gromms/MiniSumo/README.md

# MiniSumo
Repository of mini sumo robot's electronics and programs of "Robotics Project" course.

# Team members
* Gromet Spaal
* Martin Maidla
* Simmo Saan
