gromms/MiniSumo/Sumo_main.step

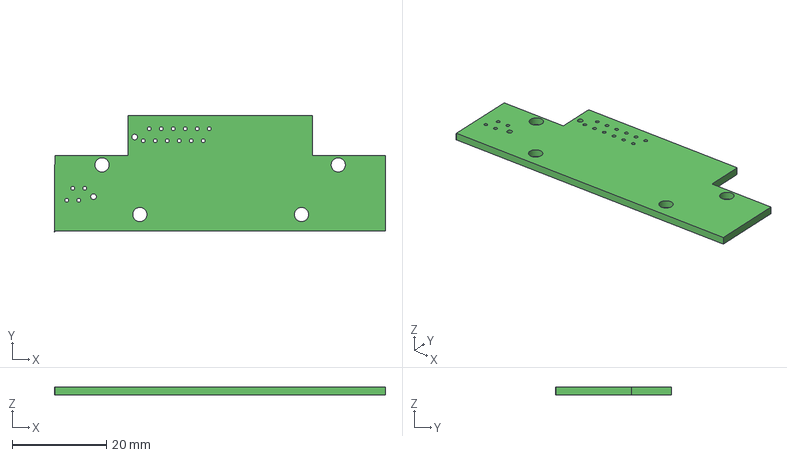
[picture p1: CAD file, 2016-04-14]
Sumo_main.step
70.1 x 24.6 x 1.59 mm
