gromms/MiniSumo/Sumo_control.step

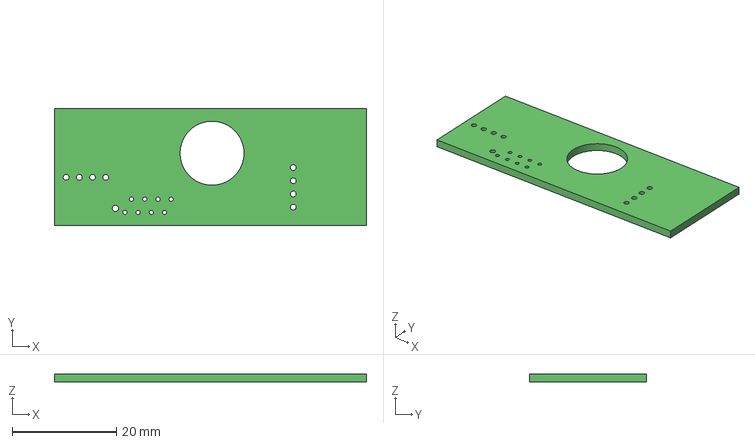
[picture p2: CAD file, 2016-04-14]
Sumo_control.step
60.0 x 22.5 x 1.59 mm
