gromms/MiniSumo/Sumo_sensors.brd

## EAGLE design Sumo_sensors.brd (2016-05-26)

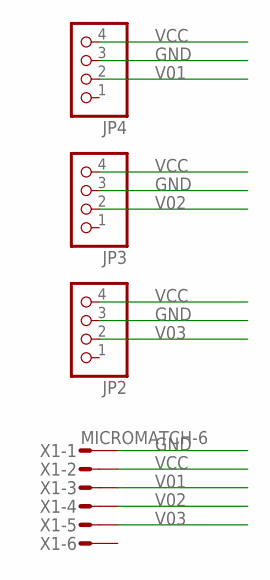
[picture p3: schematic Sumo_sensors.sch]

Parts:
JP2, JP3, JP4: PINHD-1X4; 1X04
X1: MICROMATCH-6

Connections:
GND: JP2.3, JP3.3, JP4.3, X1.1
V01: JP4.2, X1.3
V02: JP3.2, X1.4
V03: JP2.2, X1.5
VCC: JP2.4, JP3.4, JP4.4, X1.2

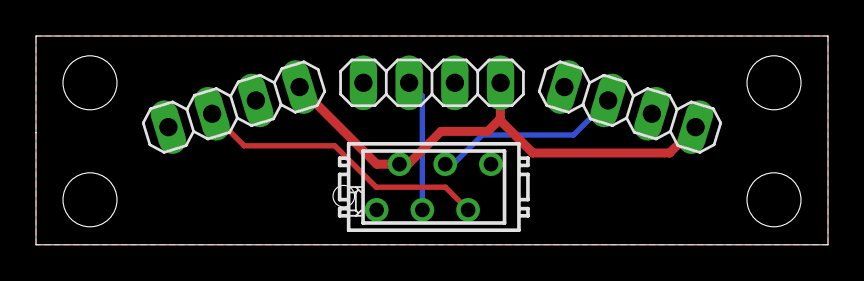
[picture p4: board Sumo_sensors.brd from above]

Board: 2 copper layers, 44.0 x 11.6 mm, 4 parts (0 on the bottom side), 5 nets.
