gromms/MiniSumo/Sumo_main.brd

## EAGLE design Sumo_main.brd (2016-05-26)

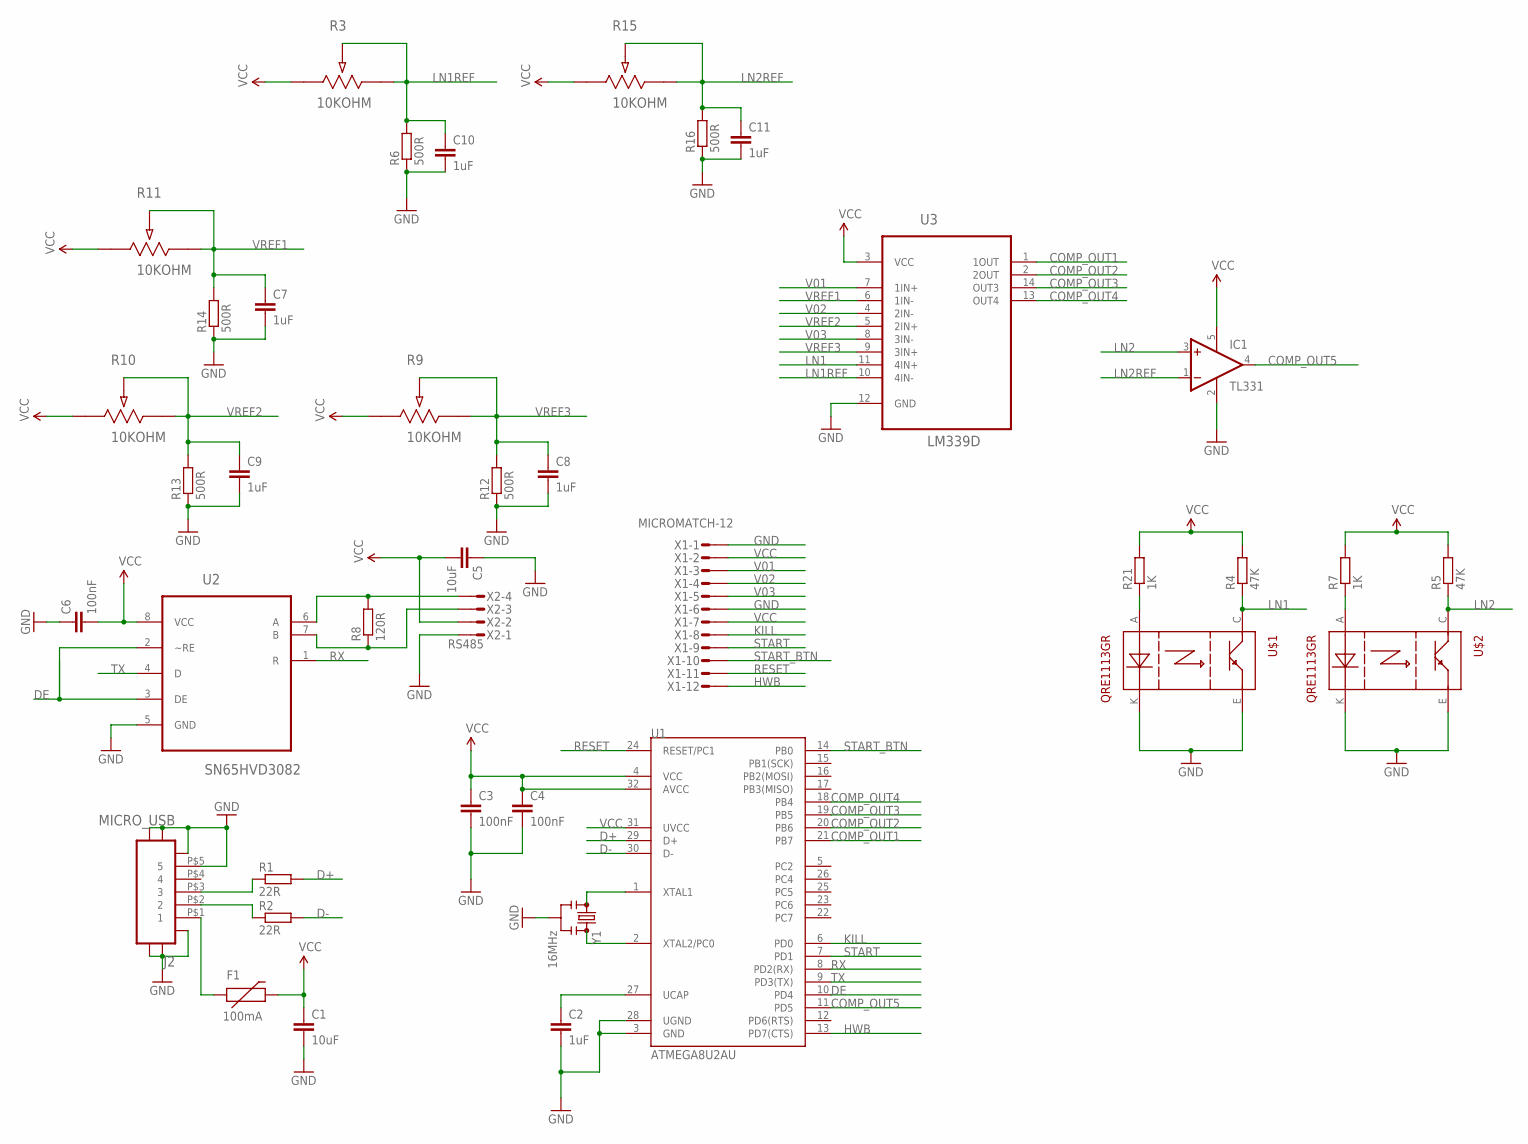
[picture p5: schematic Sumo_main.sch]

Parts:
C1, C5: 10uF; 0603-CAP
C2, C7, C8, C9, C10, C11: 1uF; 0603-CAP
C3, C4, C6: 100nF; 0603-CAP
F1: 100mA; PTC-1206
IC1: TL331; DBV-R-PDSO-G5
J2: MICRO_USB; MOLEX_47346-0001
R1, R2: 22R; R0603
R3, R9, R10, R11, R15: 10KOHM; POT_EVM3W
R4, R5: 47K; R0603
R6, R12, R13, R14, R16: 500R; R0603
R7, R21: 1K; R0603
R8: 120R; R0603
U1: ATMEGA8U2AU; TQFP32-08
U2: SN65HVD3082; SOIC127P600X175-8N
U3: LM339D; SOIC127P600X175-14N
U$1, U$2: QRE1113GR; 4LEADSMD
X1: MICROMATCH-12
X2: RS485; MICROMATCH-4
Y1: 16MHz; RESONATOR-SMD_MED

Connections:
COMP_OUT1: U1.21 (PB7), U3.1 (1OUT)
COMP_OUT2: U1.20 (PB6), U3.2 (2OUT)
COMP_OUT3: U1.19 (PB5), U3.14 (OUT3)
COMP_OUT4: U1.18 (PB4), U3.13 (OUT4)
COMP_OUT5: IC1.4 (OUT), U1.11 (PD5)
D+: R1.2, U1.29 (D+)
D-: R2.2, U1.30 (D-)
DE: U1.10 (PD4), U2.2 (~RE), U2.3 (DE)
GND: C1.2, C2.2, C3.2, C4.2, C5.1, C6.1, C7.2, C8.2, C9.2, C10.2, C11.2, IC1.2 (GND), J2.M1, J2.M2, J2.M3, J2.M4, J2.M5, J2.M6, J2.P$5 (5), R6.1, R12.1, R13.1, R14.1, R16.1, U1.3 (GND), U1.28 (UGND), U2.5 (GND), U3.12 (GND), U$1.E, U$1.K, U$2.E, U$2.K, X1.1, X1.6, X2.1, Y1.2
HWB: U1.13 (PD7(CTS)), X1.12
KILL: U1.6 (PD0), X1.8
LN1: R4.1, U3.11 (4IN+), U$1.C
LN1REF: C10.1, R3.2, R3.3, R6.2, U3.10 (4IN-)
LN2: IC1.3 (+IN), R5.1, U$2.C
LN2REF: C11.1, IC1.1 (-IN), R15.2, R15.3, R16.2
unnamed: J2.P$3 (3), R1.1
unnamed: J2.P$2 (2), R2.1
unnamed: F1.1, J2.P$1 (1)
unnamed: R21.1, U$1.A
unnamed: U1.1 (XTAL1), Y1.1
unnamed: U1.2 (XTAL2/PC0), Y1.3
unnamed: C2.1, U1.27 (UCAP)
unnamed: R7.1, U$2.A
unnamed: R8.2, U2.6 (A), X2.4
unnamed: R8.1, U2.7 (B), X2.3
RESET: U1.24 (RESET/PC1), X1.11
RX: U1.8 (PD2(RX)), U2.1 (R)
START: U1.7 (PD1), X1.9
START_BTN: U1.14 (PB0), X1.10
TX: U1.9 (PD3(TX)), U2.4 (D)
V01: U3.7 (1IN+), X1.3
V02: U3.4 (2IN-), X1.4
V03: U3.8 (3IN-), X1.5
VCC: C1.1, C3.1, C4.1, C5.2, C6.2, F1.2, IC1.5 (V+), R3.1, R4.2, R5.2, R7.2, R9.1, R10.1, R11.1, R15.1, R21.2, U1.4 (VCC), U1.31 (UVCC), U1.32 (AVCC), U2.8 (VCC), U3.3 (VCC), X1.2, X1.7, X2.2
VREF1: C7.1, R11.2, R11.3, R14.2, U3.6 (1IN-)
VREF2: C9.1, R10.2, R10.3, R13.2, U3.5 (2IN+)
VREF3: C8.1, R9.2, R9.3, R12.2, U3.9 (3IN+)

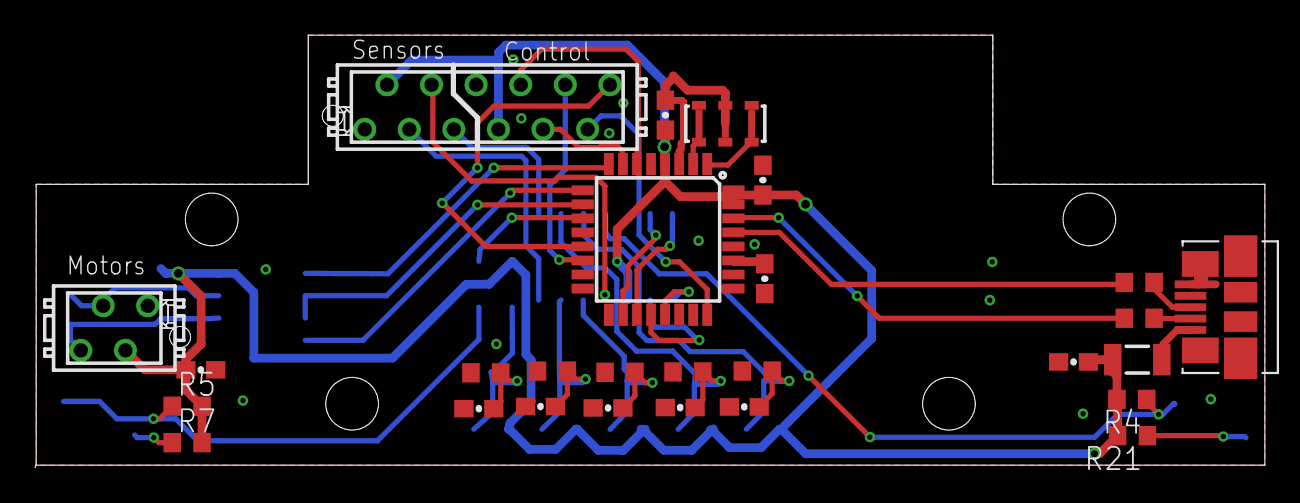
[picture p6: board Sumo_main.brd from above]

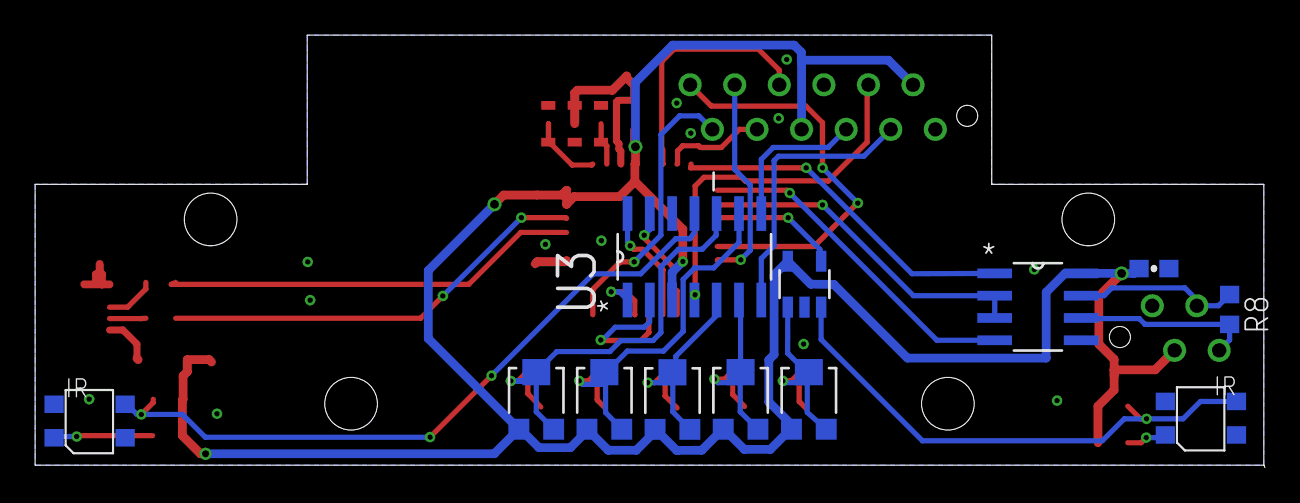
[picture p7: board Sumo_main.brd from below]

Board: 2 copper layers, 70.0 x 24.5 mm, 39 parts (12 on the bottom side), 37 nets.
