gromms/MiniSumo/Sumo_control.brd

## EAGLE design Sumo_control.brd (2016-04-14)

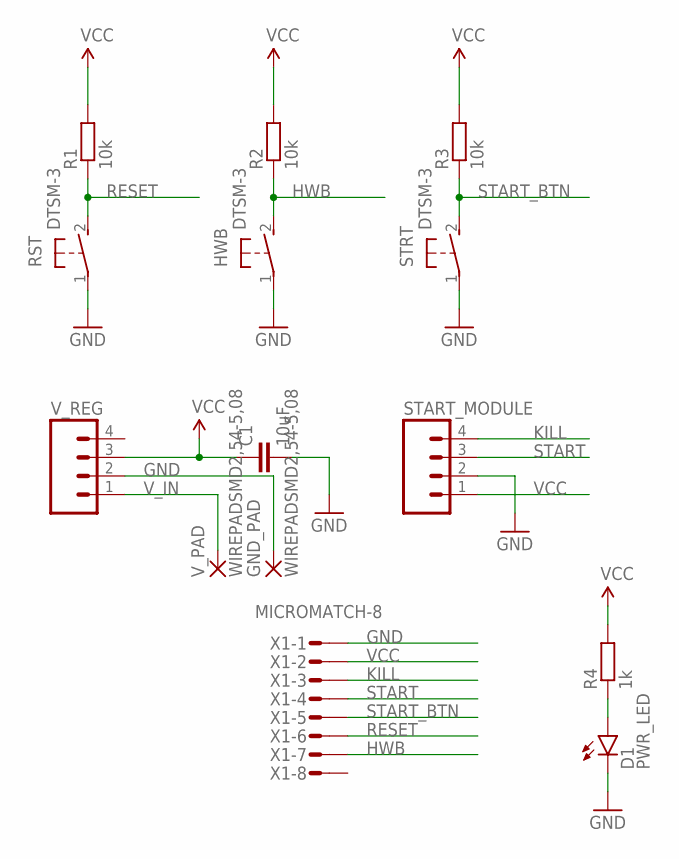
[picture p8: schematic Sumo_control.sch]

Parts:
C1: 10uF; 0603-CAP
D1: PWR_LED; LED-0603
GND_PAD: WIREPADSMD2,54-5,08; SMD2,54-5,08
HWB: DTSM-3
R1, R2, R3: 10k; R0603
R4: 1k; R0603
RST: DTSM-3
START_MODULE: M04LONGPADS; 1X04_LONGPADS
STRT: DTSM-3
V_PAD: WIREPADSMD2,54-5,08; SMD2,54-5,08
V_REG: M04LONGPADS; 1X04_LONGPADS
X1: MICROMATCH-8

Connections:
GND: C1.2, D1.C, GND_PAD.1, HWB.1, RST.1, START_MODULE.2, STRT.1, V_REG.2, X1.1
HWB: HWB.2, R2.1, X1.7
KILL: START_MODULE.4, X1.3
unnamed: D1.A, R4.1
RESET: R1.1, RST.2, X1.6
START: START_MODULE.3, X1.4
START_BTN: R3.1, STRT.2, X1.5
VCC: C1.1, R1.2, R2.2, R3.2, R4.2, START_MODULE.1, V_REG.3, X1.2
V_IN: V_PAD.1, V_REG.1

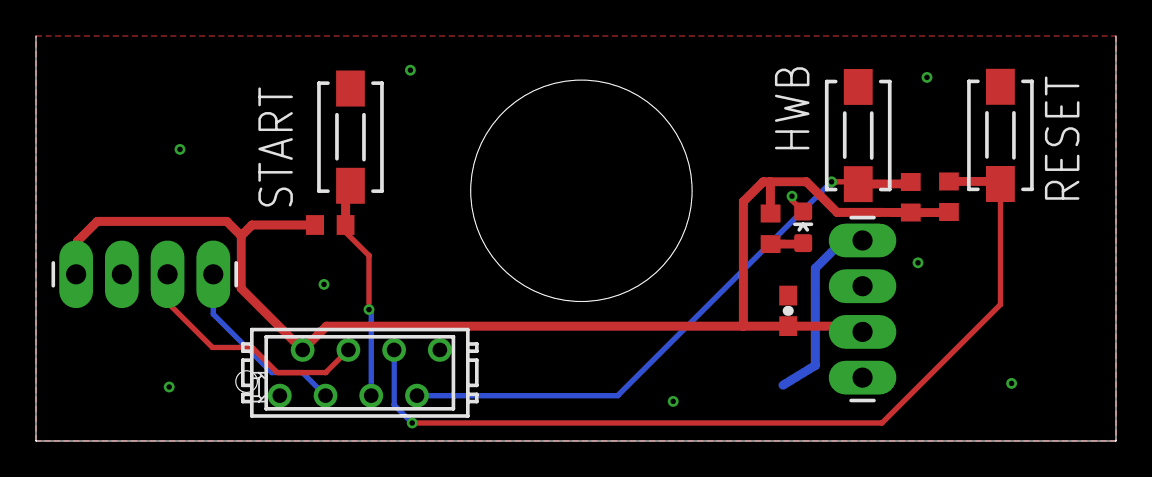
[picture p9: board Sumo_control.brd from above]

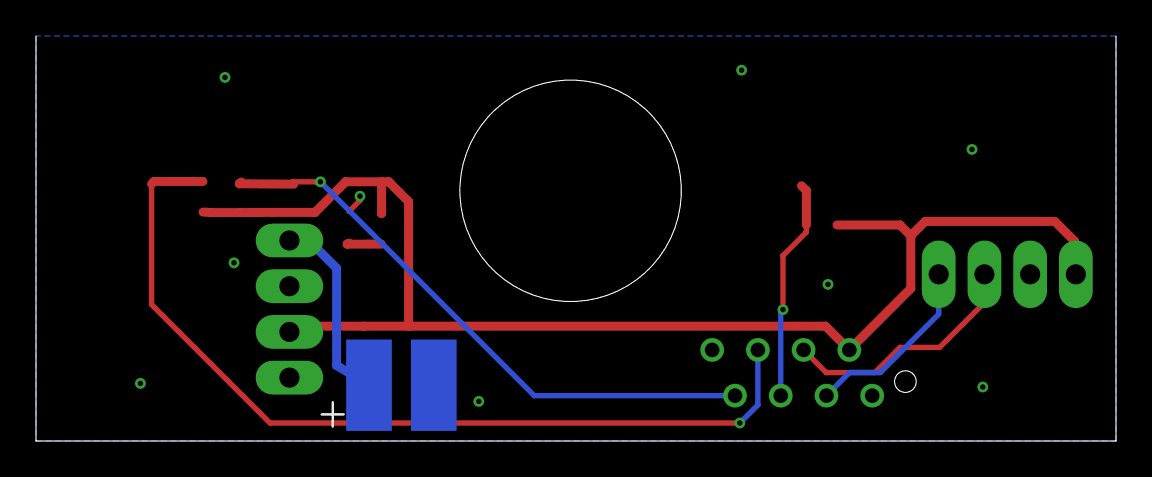
[picture p10: board Sumo_control.brd from below]

Board: 2 copper layers, 60.0 x 22.5 mm, 14 parts (2 on the bottom side), 9 nets.
