gromms/MiniSumo/(threads)

Thread 13 (2016-05-31):

Prevent LiPo draining

sim642, 2016-05-31:
Possible solutions:
- LiPo alarms (could maybe fit under top layer) - requires connector to split off
- Measurement and shutdown by external chip
- Measurement and shutdown by atmega

gromms, 2016-06-01:
Motors' power could be switched by a relay. In that case we could use a LiPo alarm that would send a signal to cut off the power to motors. (Con: size of relays)
