gromms/MiniSumo/(commit log)

2016-02-04 Added schematic file
    [Sumo_main.sch]
2016-02-04 Added RS-485
    [Sumo_main.sch]
2016-02-09 Added Non-USB voltage supply.
    [Sumo_main.sch]
2016-02-10 Changed RS485 module, added start module and power voltage regulator.
    [Sumo_main.sch]
2016-02-10 Changed power switch in schematic for pin headers to connect it with wires later.
    [Sumo_main.sch]
2016-02-10 Bug fixes.
    [Sumo_main.sch]
2016-02-10 Signal bug fixes.
    [Sumo_main.sch]
2016-02-10 Added capacitor to RS-485 chip's VCC and connected RS-485 micromatch VCC capacitor to ground.
    [Sumo_main.sch]
2016-02-10 Added ready board and Gerber files.
    [Sumo_main.GBL, Sumo_main.GBO, Sumo_main.GBP, Sumo_main.GBS, Sumo_main.GTL, Sumo_main.GTO, Sumo_main.GTP, Sumo_main.GTS]
2016-02-10 Added PNGs of schematic and board, added text to schematic and board and shortened some components' names.
    [Sumo_main.GBL, Sumo_main.GBO, Sumo_main.GBP, Sumo_main.GBS, Sumo_main.GTL, Sumo_main.GTO, Sumo_main.GTP, Sumo_main.GTS]
2016-02-16 Version 2 - added comparator for sensor signals, redesigned board to be more compact.
    [Sumo_main.brd, Sumo_main.sch]
2016-02-16 Re-routed X6 signal and VCC.
    [Sumo_main.brd]
2016-02-16 Moved ATMEGA more to center of the board.
    [Sumo_main.brd]
2016-02-18 Made the board more compact.
    [Sumo_main.brd]
2016-03-03 Added additional button for starting. Changed IR sensors' micromatches to pinheaders.
    [Sumo_main.brd, Sumo_main.sch]
2016-03-09 Add two IR reflection sensors to detect lines.
    [Sumo_main.brd, Sumo_main.sch]
2016-03-09 Add PNG pictures of v04 Schematic and Board.
2016-04-04 Add line sensor to schematic.
    [Sumo_main.sch]
2016-04-04 Start arranging new board.
    [Sumo_main.brd]
2016-04-04 Remove unnecessary components that are moved to other board.
    [Sumo_main.sch]
2016-04-04 Board redesign. TODO: Connect HWB
    [Sumo_main.brd]
2016-04-04 Add control board schematic and board
    [Sumo_control.brd, Sumo_control.sch]
2016-04-05 Finish and fix errors of Main's schematic and board
    [Sumo_main.brd, Sumo_main.sch]
2016-04-05 Wire one unwired signal
    [Sumo_main.brd]
2016-04-05 Remove old Gerber folder and files
    [Sumo_main.GBL, Sumo_main.GBO, Sumo_main.GBP, Sumo_main.GBS, Sumo_main.GTL, Sumo_main.GTO, Sumo_main.GTP, Sumo_main.GTS]
2016-04-05 Adjust control board to meet right EDC requirements
    [Sumo_control.brd]
2016-04-12 Add mounting holes to board and re-route some wires to get rid of some vias.
    [Sumo_main.brd]
2016-04-12 Adjust GND plate to actual board shape
    [Sumo_main.brd]
2016-04-12 Adjust blocks' placements
    [Sumo_main.sch]
2016-04-12 Add isolation to polygon
    [Sumo_control.brd]
2016-04-12 Mark correct PCB shape
    [Sumo_main.brd]
2016-04-12 Replace power pads with bigger ones
    [Sumo_control.brd, Sumo_control.sch]
2016-04-14 Add STEP files of component-less main board
    [Sumo_control.step, Sumo_main.step]
2016-04-14 Final modifications before test order
    [Sumo_control.brd, Sumo_control.sch, Sumo_main.brd]
2016-05-13 Tested dual motor communication and all distance sensors
2016-05-24 Swap light sensor left and right to match reality
    [comms.c, minisumo.c, pins.h]
2016-05-24 Reverse from black line
    [minisumo.c]
2016-05-25 Add LED and START_BTN interrupt
2016-05-26 Replace START_BTN interrupt with polling
    [minisumo.c]
2016-05-26 Update main board and schematic
    [Sumo_main.brd, Sumo_main.sch]
2016-05-26 Add sensor board and schematic
    [Sumo_sensors.brd, Sumo_sensors.sch]
2016-05-26 Remove button-sensor code
2016-05-26 Invert light sensor values for white border
    [minisumo.c]
2016-05-26 Fix distance sensor order
    [pins.h]
2016-05-26 Fix left/right distance sensor side
    [minisumo.c]
2016-05-26 Fix both attack turns being same, increase speeds
    [minisumo.c]
2016-05-27 Replace single wheel turn reversing with single wheel forwarding
    [minisumo.c]
2016-06-01 Reduce speeds for unsuitable battery mass placement
2016-06-01 Create function for driving motors
2016-06-02 Reduce speeds even further, shorten reaction delay
    [minisumo.c]
2016-06-02 Add delay between motor commands to ensure both motors receive correctly
    [comms.c, minisumo.c]
